aumaranin/course_project_mps/docs/Схема_функциональная.pdf

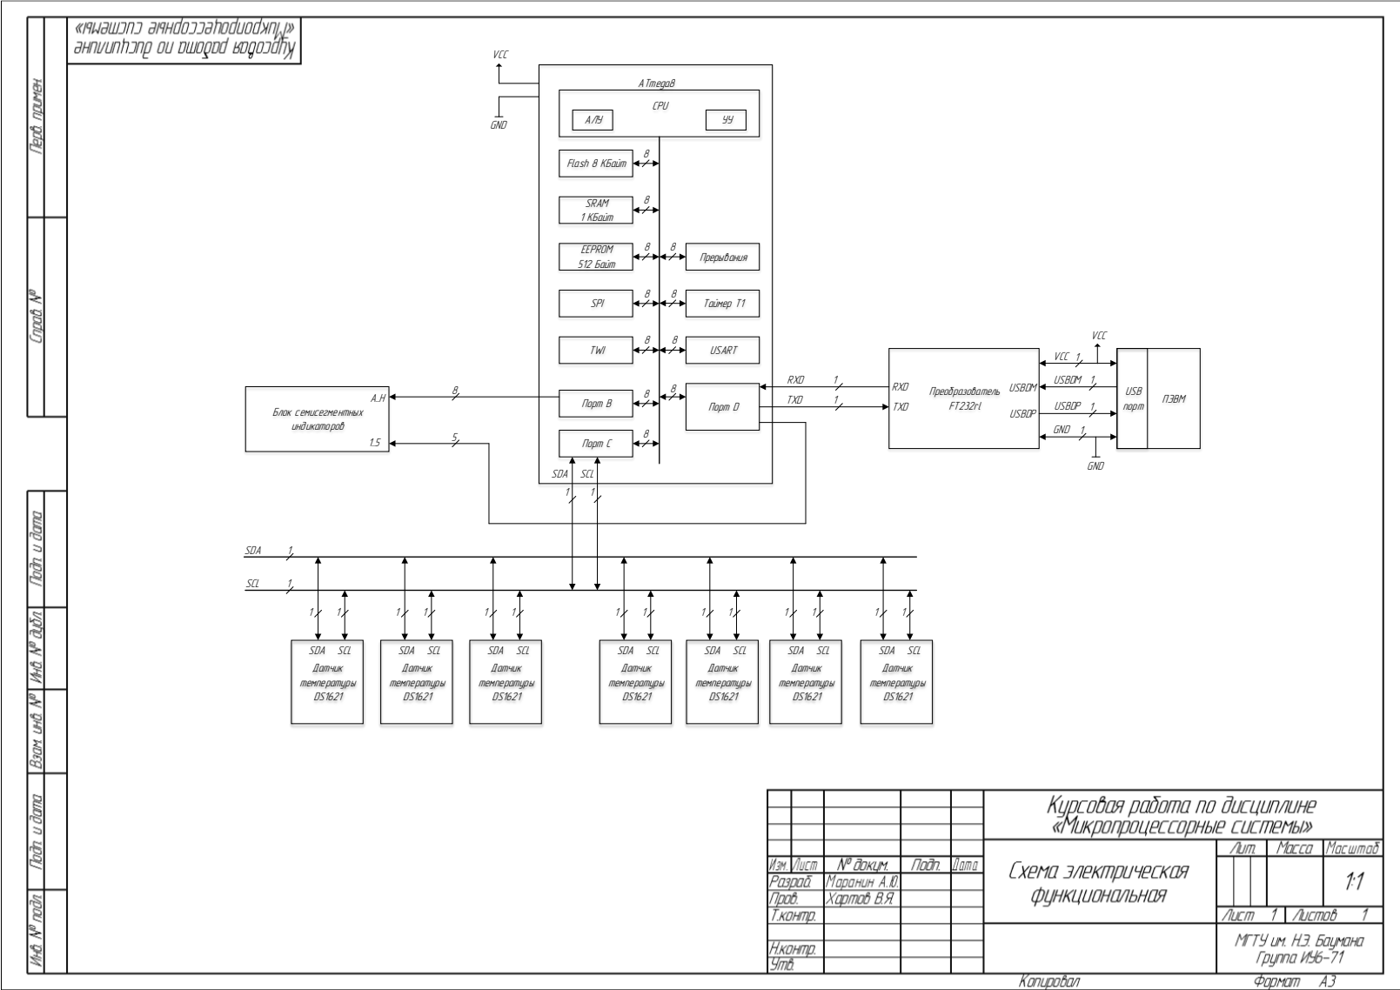
[picture p4: page 1]

CPU
АЛУ | УУ

Flash 8 КБайт

SRAM
1 КБайт

EEPROM
512 Байт

Прерывания

SPI

TWI | USART

Порт D

Порт B

Порт C

Таймер T1

ATmega8

VCC

GND

Блок семисегментных
индикаторов

SDA

SCL

RXD

TXD

Преобразователь
FT232rl

ПЭВМ

USBDM

USBDP

1

1

1

1

1 1

1

1

1 | 1 | 1 | 1 | 1 | 1 | 1 | 1 | 1 | 1 | 1 | 1

8

5

RXD

TXD

USBDM

USBDP

1 | 1
SDA | SCL

Датчик
температуры
DS1621

SDA SCL
Датчик
температуры
DS1621

SDA SCL
Датчик
температуры
DS1621

SDA SCL
Датчик
температуры
DS1621

SDA SCL
Датчик
температуры
DS1621

SDA SCL
Датчик
температуры
DS1621

SDA SCL
Датчик
температуры
DS1621

SDA SCL

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
A..H

1..5

USB
порт

VCC 1

GND 1

VCC

GND
