aumaranin/course_project_mps/docs/Схема_принципиальная.pdf

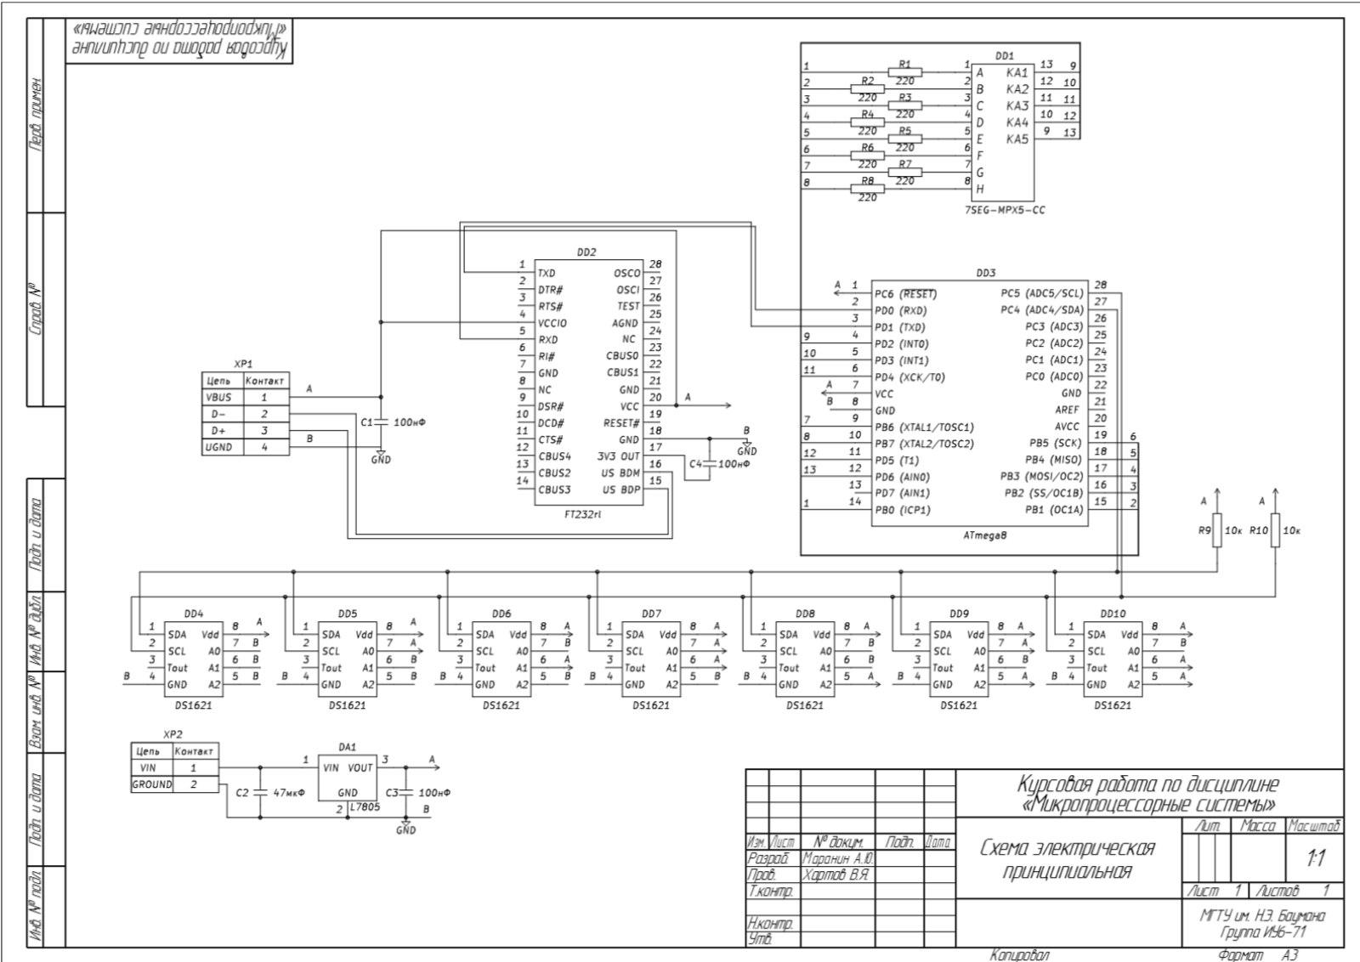
[picture p31: page 1]
