aumaranin/course_project_mps/(list of files, cad)

Other CAD files:
codevision_files/kurs_obsh_1.obj
