aumaranin/course_project_mps/(list of files, drawings)

Other design files:
proteus_project/kurs_obsh_3.pdsprj
