aumaranin/course_project_mps/(commit log)

2024-10-04 Добавлен проект и документация.
    [kurs_obsh_1.obj, kurs_obsh_3.pdsprj]
2024-10-04 Заменено РПЗ.
2024-10-04 Исправлен файл README.md
